Tomzopo/Smartphone-Based-Smart-Card-Reader/Circuit Diagrams & Pictures/IMG_3034.JPG

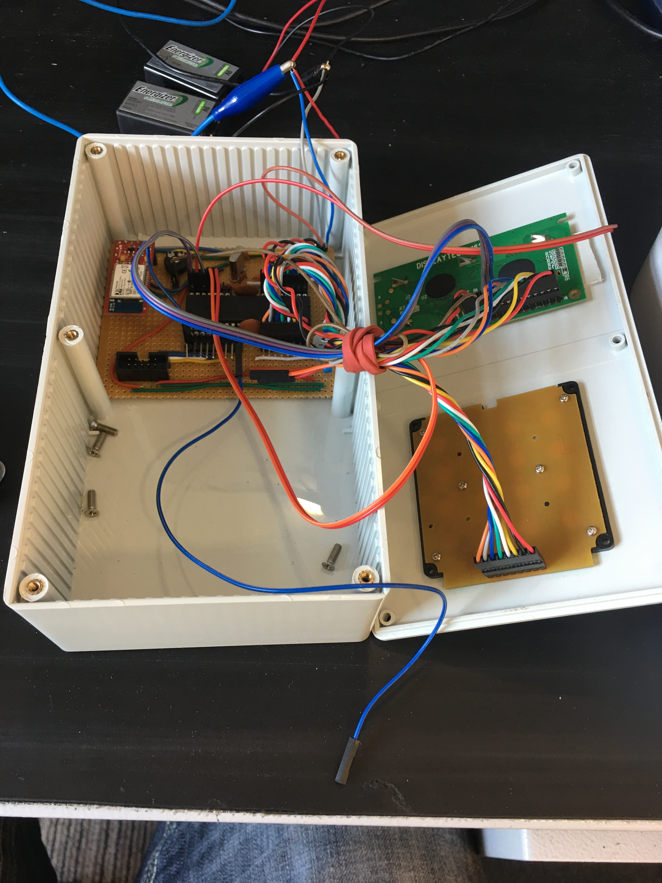
Circuit Diagrams & Pictures/IMG_3034.JPG
