Tomzopo/Smartphone-Based-Smart-Card-Reader/Circuit Diagrams & Pictures/IMG_3033.JPG

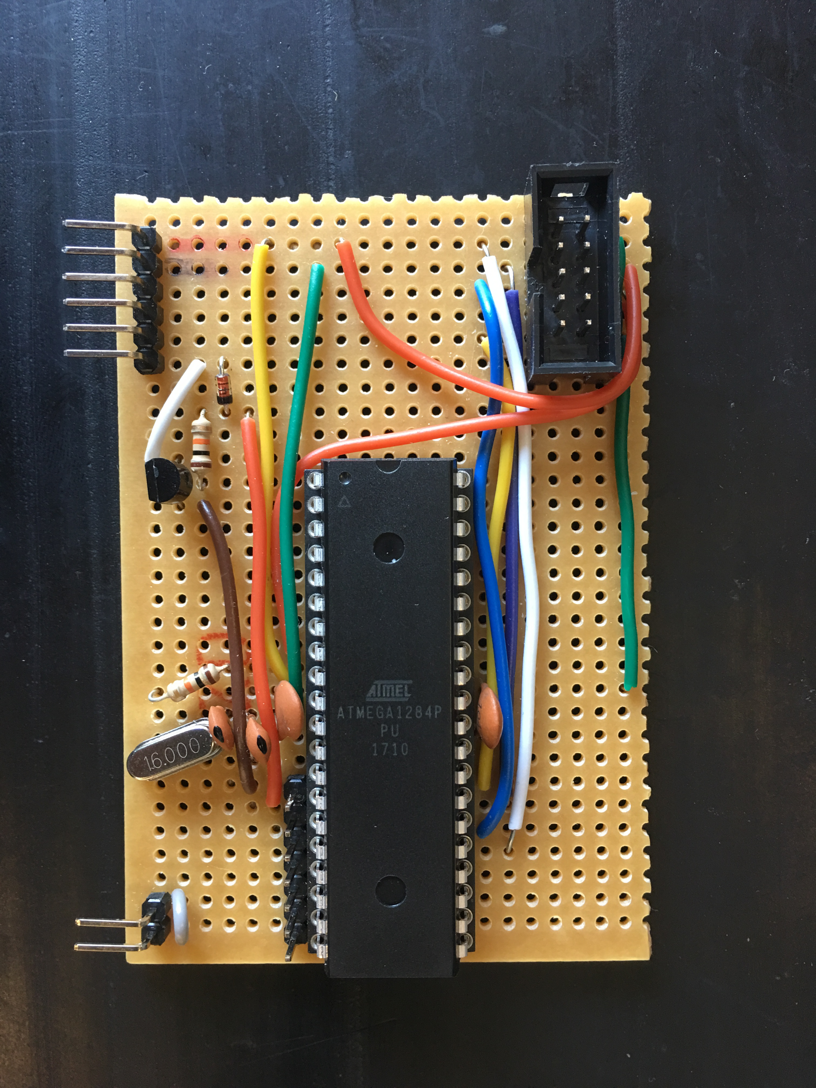
Circuit Diagrams & Pictures/IMG_3033.JPG
