Tomzopo/Smartphone-Based-Smart-Card-Reader/Circuit Diagrams & Pictures/IMG_3035.JPG

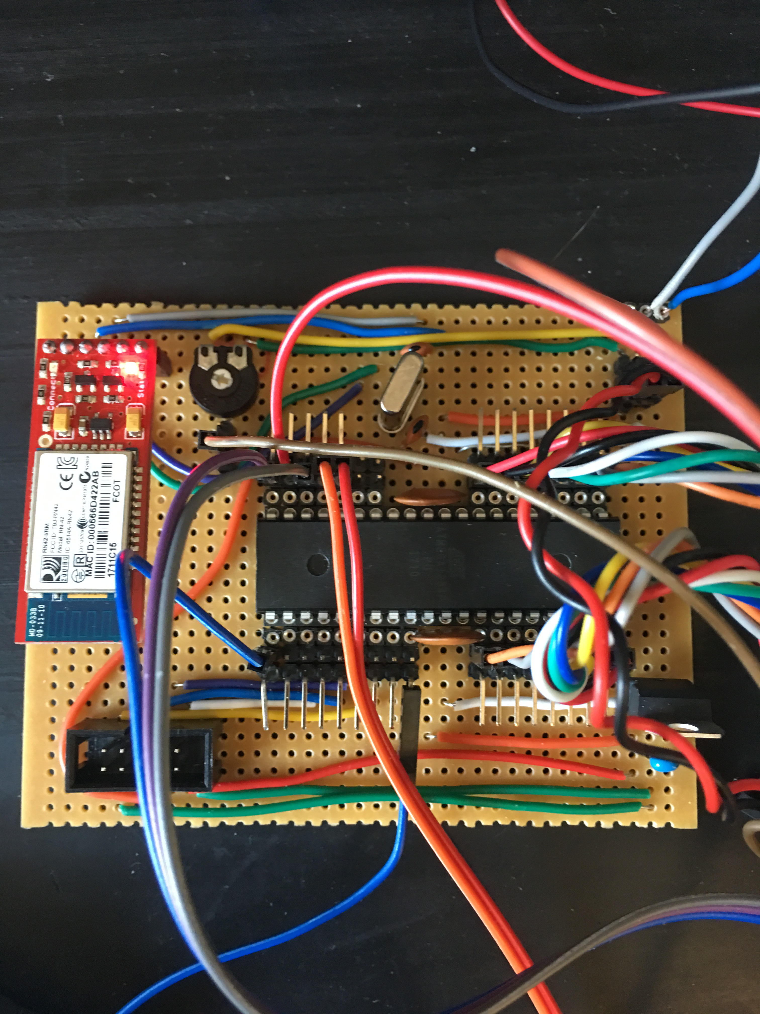
Circuit Diagrams & Pictures/IMG_3035.JPG
