Tomzopo/Smartphone-Based-Smart-Card-Reader/Phone App Pictures/Screenshot_2017-10-25-13-54-01.png

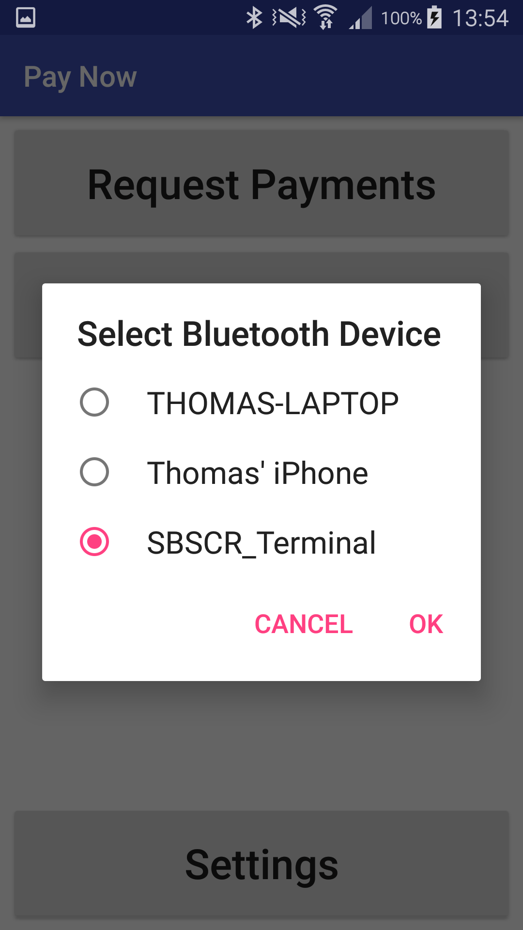
Phone App Pictures/Screenshot_2017-10-25-13-54-01.png
