Tomzopo/Smartphone-Based-Smart-Card-Reader/Phone App Pictures/Screenshot_2017-10-26-16-55-03.png

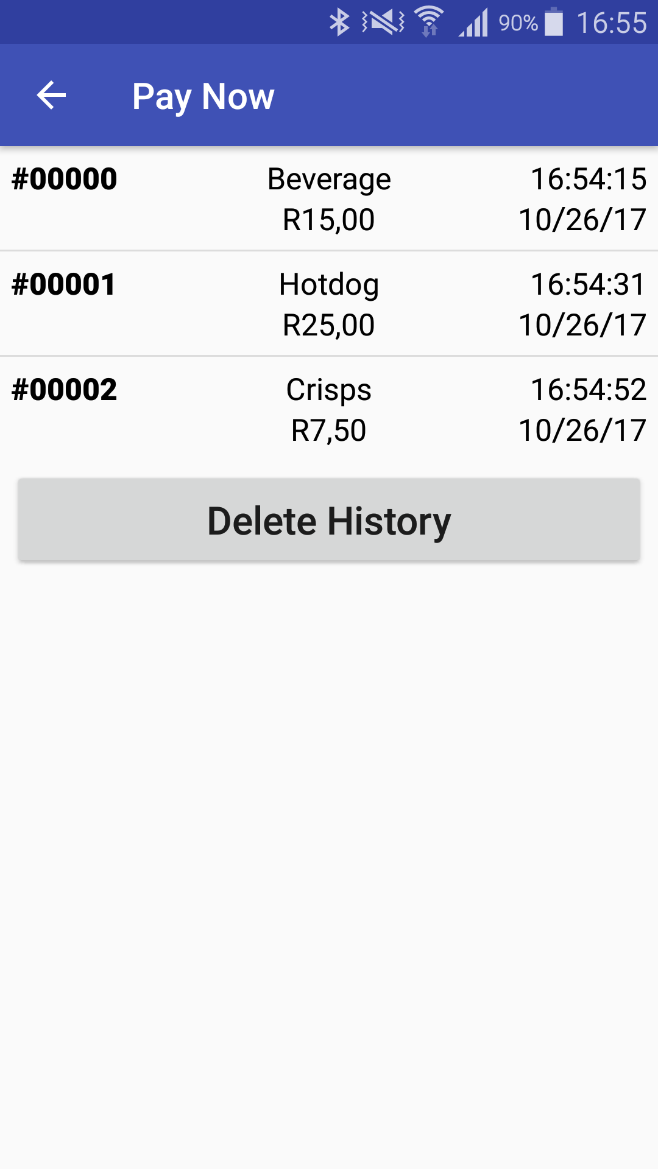
Phone App Pictures/Screenshot_2017-10-26-16-55-03.png
