Tomzopo/Smartphone-Based-Smart-Card-Reader/Circuit Diagrams & Pictures/1-Wire UART.pdf

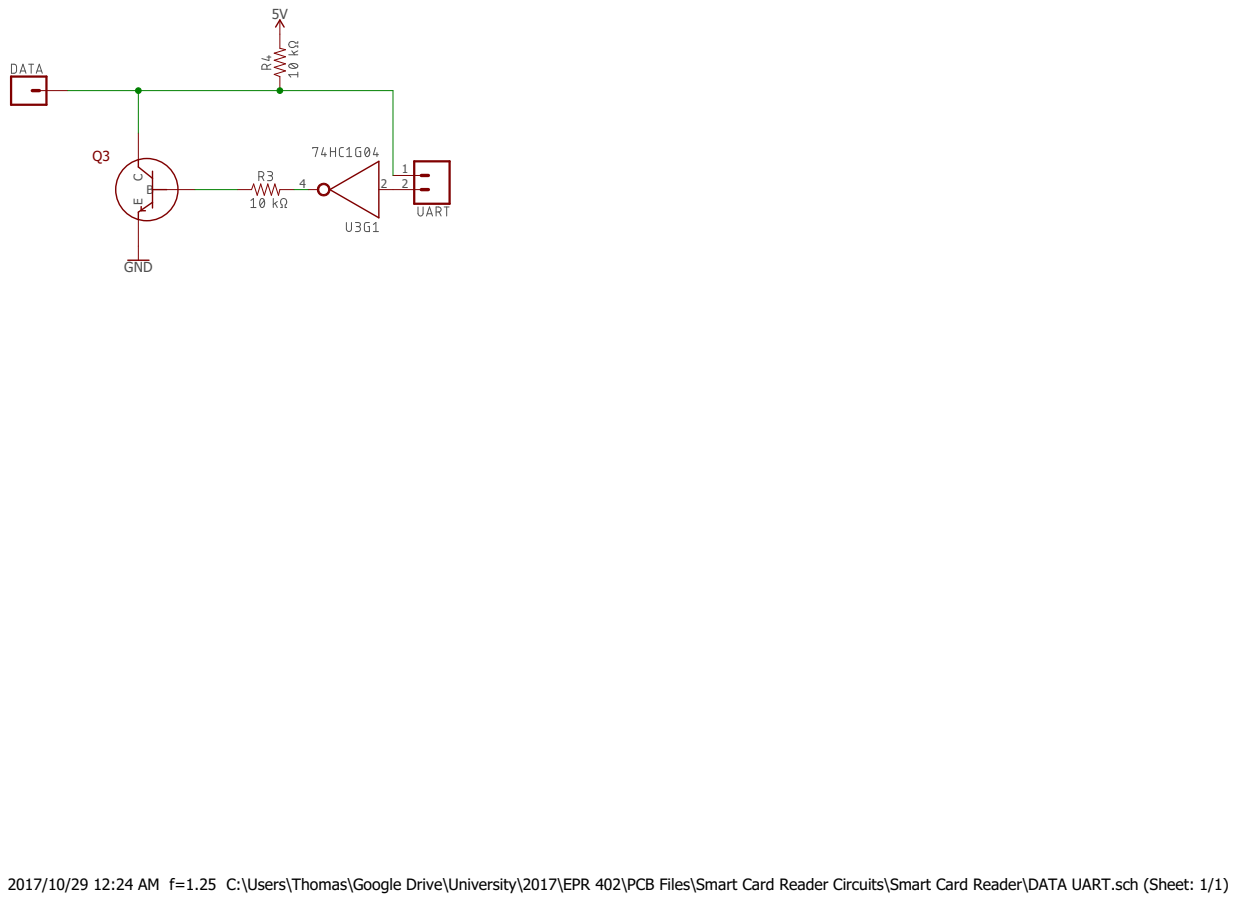
[picture p51: page 1]

2017/10/29 12:24 AM f=1.25 C:\Users\Thomas\Google Drive\University\2017\EPR 402\PCB Files\Smart Card Reader Circuits\Smart Card Reader\DATA UART.sch (Sheet: 1/1)
