Tomzopo/Smartphone-Based-Smart-Card-Reader/Circuit Diagrams & Pictures/Interface.pdf

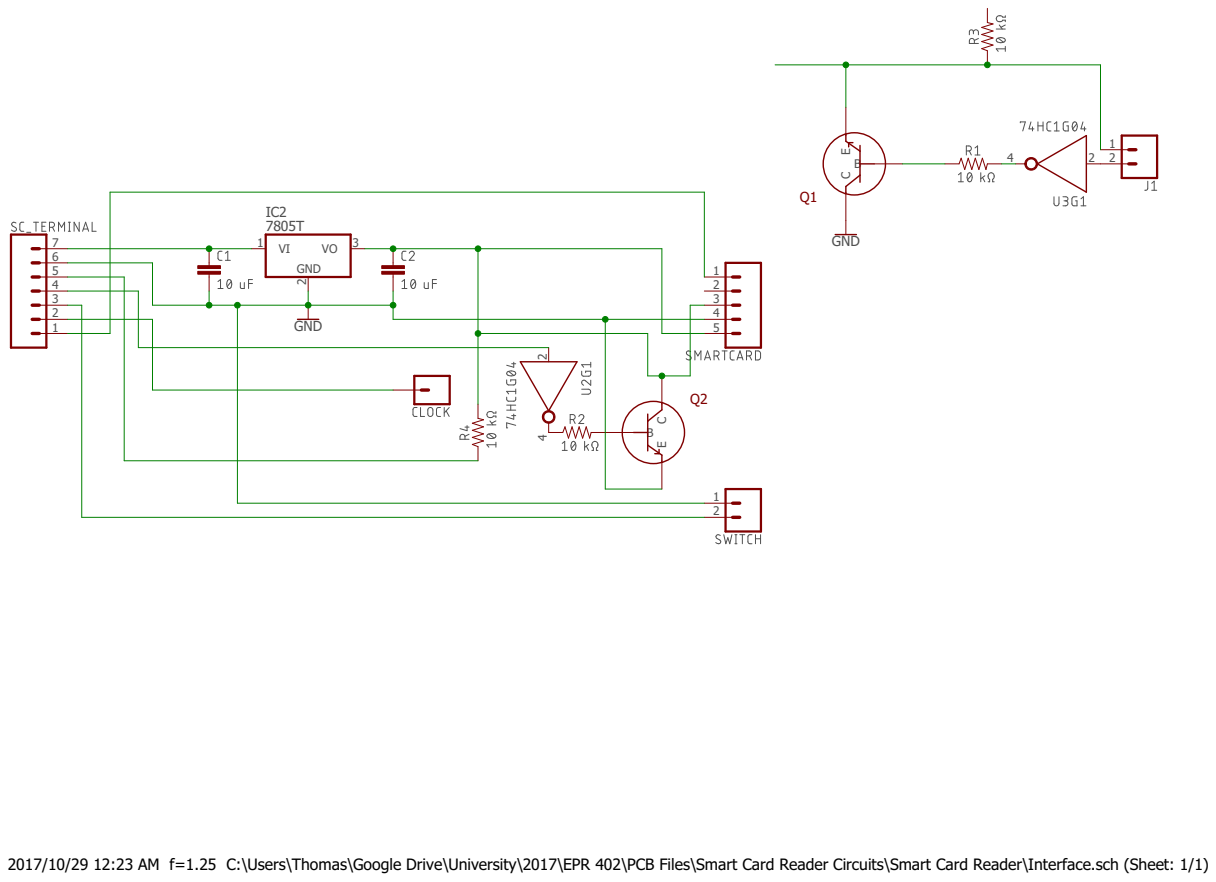
[picture p52: page 1]

2017/10/29 12:23 AM f=1.25 C:\Users\Thomas\Google Drive\University\2017\EPR 402\PCB Files\Smart Card Reader Circuits\Smart Card Reader\Interface.sch (Sheet: 1/1)
