Tomzopo/Smartphone-Based-Smart-Card-Reader/Circuit Diagrams & Pictures/Smart Card.pdf

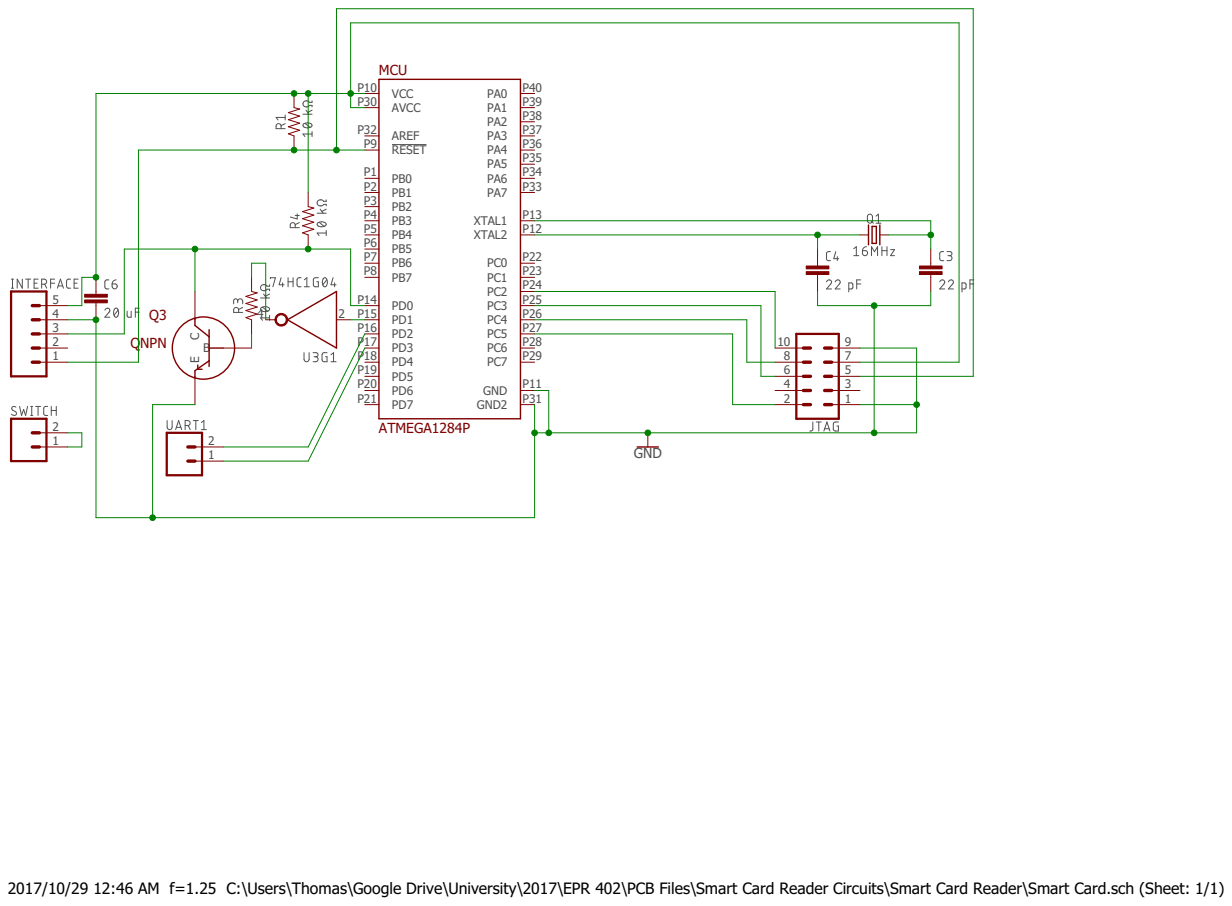
[picture p53: page 1]

2017/10/29 12:46 AM f=1.25 C:\Users\Thomas\Google Drive\University\2017\EPR 402\PCB Files\Smart Card Reader Circuits\Smart Card Reader\Smart Card.sch (Sheet: 1/1)
