Tomzopo/Smartphone-Based-Smart-Card-Reader/Circuit Diagrams & Pictures/Terminal.pdf

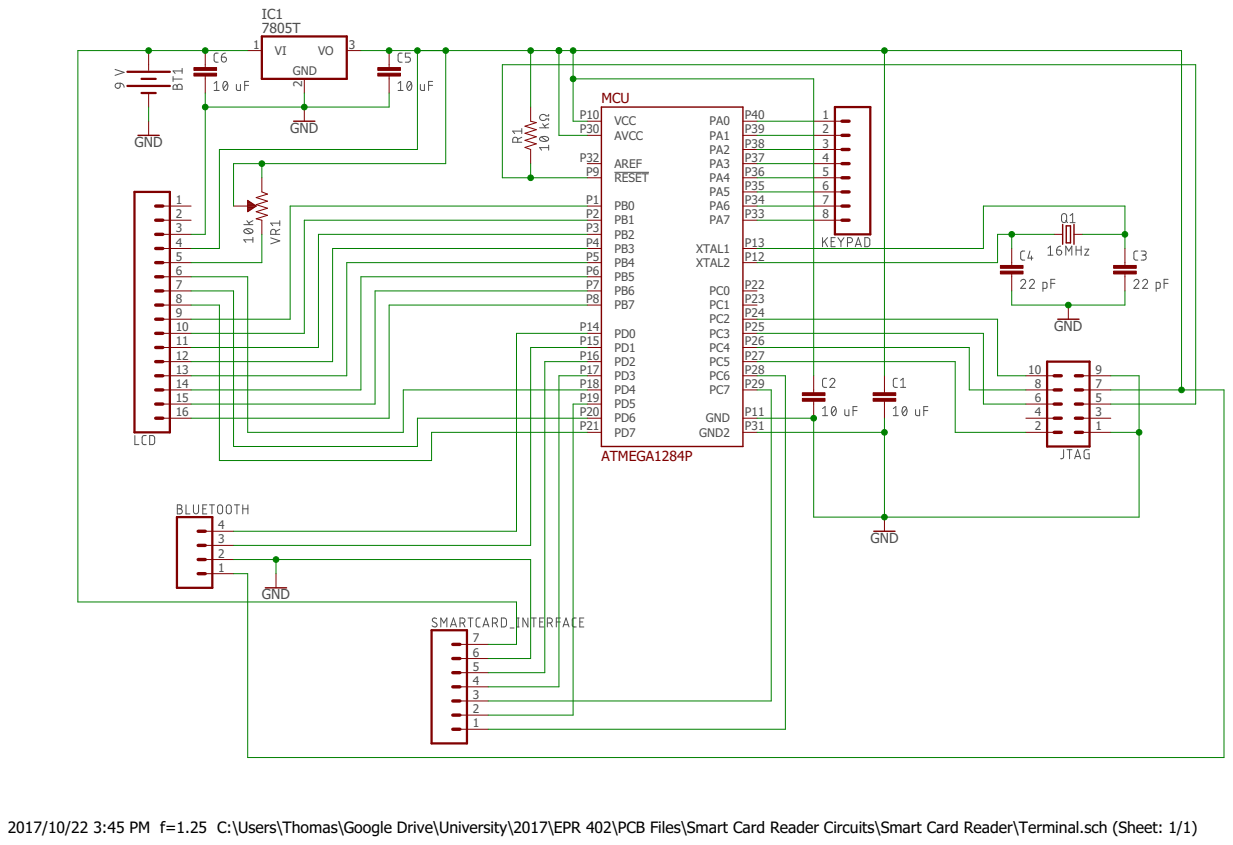
[picture p54: page 1]

2017/10/22 3:45 PM f=1.25 C:\Users\Thomas\Google Drive\University\2017\EPR 402\PCB Files\Smart Card Reader Circuits\Smart Card Reader\Terminal.sch (Sheet: 1/1)
