Tomzopo/Smartphone-Based-Smart-Card-Reader/SBSCR_SmartCard/SBSCR_SmartCard/boxes.h

/*
Author: Thomas Stewart
*/

#ifndef BOXES_H
#define BOXES_H
//All Sizes are for the output table size

//Initial permutation (IP)
 uint8_t IP_Size = 64;
 uint8_t IP[] =        
{
58, 50, 42, 34, 26, 18, 10, 2,
60, 52, 44, 36, 28, 20, 12, 4,
62, 54, 46, 38, 30, 22, 14, 6,
64, 56, 48, 40, 32, 24, 16, 8,
57, 49, 41, 33, 25, 17,  9, 1,
59, 51, 43, 35, 27, 19, 11, 3,
61, 53, 45, 37, 29, 21, 13, 5,
63, 55, 47, 39, 31, 23, 15, 7
};


//Final permutation (IP^1)
 uint8_t FP_Size = 64;
 uint8_t FP[] =
{
40, 8, 48, 16, 56, 24, 64, 32,
39, 7, 47, 15, 55, 23, 63, 31,
38, 6, 46, 14, 54, 22, 62, 30,
37, 5, 45, 13, 53, 21, 61, 29,
36, 4, 44, 12, 52, 20, 60, 28,
35, 3, 43, 11, 51, 19, 59, 27,
34, 2, 42, 10, 50, 18, 58, 26,
33, 1, 41,  9, 49, 17, 57, 25
};

//Expansion function (E)
 uint8_t E_Size = 48;
 uint8_t E[] =
{
32,  1,  2,  3,  4,  5,
4,  5,  6,  7,  8,  9,
8,  9, 10, 11, 12, 13,
12, 13, 14, 15, 16, 17,
16, 17, 18, 19, 20, 21,
20, 21, 22, 23, 24, 25,
24, 25, 26, 27, 28, 29,
28, 29, 30, 31, 32,  1
};

//Permutation (P)
 uint8_t P_Size = 32;
 uint8_t P[] =         
{
16,  7, 20, 21, 29, 12, 28, 17,
1, 15, 23, 26,  5, 18, 31, 10,
2,  8, 24, 14, 32, 27,  3,  9,
19, 13, 30,  6, 22, 11,  4, 25
};

//Permuted choice 1 (PC-1)
 uint8_t PC_1_Size = 56;
 uint8_t PC_1[] =      
{
57, 49, 41, 33, 25, 17,  9,
1, 58, 50, 42, 34, 26, 18,
10,  2, 59, 51, 43, 35, 27,
19, 11,  3, 60, 52, 44, 36,
63, 55, 47, 39, 31, 23, 15,
7, 62, 54, 46, 38, 30, 22,
14,  6, 61, 53, 45, 37, 29,
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

	//sBox 8
	{	13,  2,  8,  4,  6, 15, 11,  1, 10,  9,  3, 14,  5,  0, 12,  7,
		1, 15, 13,  8, 10,  3,  7,  4, 12,  5,  6, 11,  0, 14,  9,  2,
		7, 11,  4,  1,  9, 12, 14,  2,  0,  6, 10, 13, 15,  3,  5,  8,
		2,  1, 14,  7,  4, 10,  8, 13, 15, 12,  9,  0,  3,  5,  6, 11}
};
#endif
